Any-Winter-4079/Uno-and-ESP32-VLA-Robot/computer/LLM/exemplars/README.md

# Notes on `computer/LLM/exemplars/`:

## Use Case

The exemplars found on this folder are used by:

- `CoT_Dec_PAL_tester_v2.py`
- `CoT_Dec_PAL_tester_v3.py`

for early LLM experiments, which are not necessary to run the robot.

The results can be seen in more detail [here](https://github.com/Any-Winter-4079/Prompting-Experiments-2024).
