Any-Winter-4079/Uno-and-ESP32-VLA-Robot/M_Sc_Computer_Engineering_Defense.pdf

## Implementación de RAG en Robot Autónomo Controlado por LLM y Análisis de Desempeño y Aprendizaje en Entornos Reales

Eduardo Ariño Pelegrín

Universidad Politécnica de Madrid, España

Eduardo Ariño Pelegrín (Universidad Politécnica de Madrid, España) Implementación de RAG en Robot Autónomo Controlado por LLM y Análisis de Desempeño y Aprendizaje en Entornos Reales 1 / 10

## Motivación

Robótica
Necesita: Solución a
problema long tail.
Provee: Interfaces y
controladores para interactuar con el mundo físico.
Modelos de lenguaje
Proveen: Mayor capacidad de generalización.
Necesitan: En transición
hacia agentic AI,
retroalimentación del mundo físico.

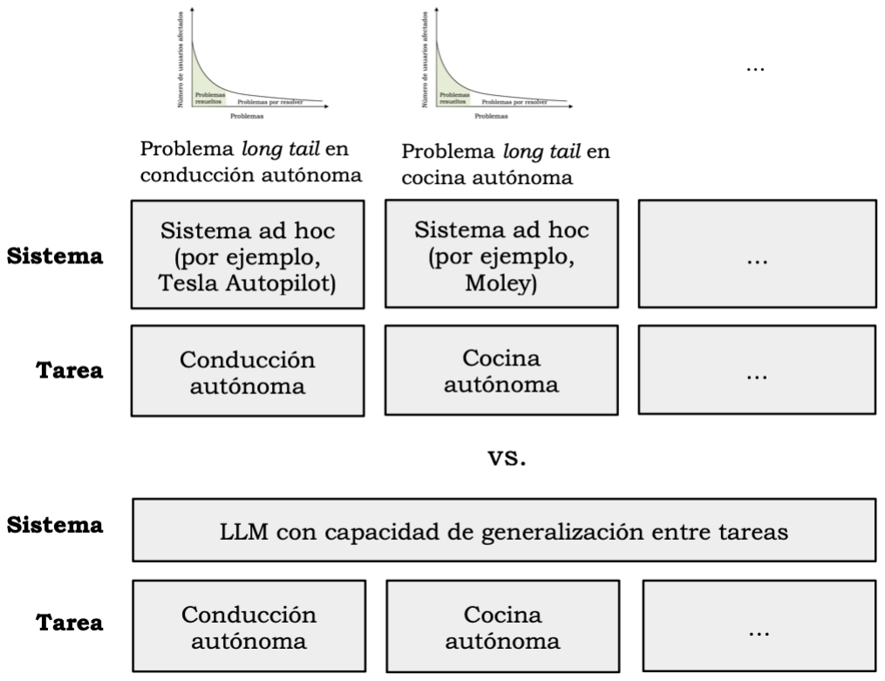
[picture p11: figure]

Eduardo Ariño Pelegrín (Universidad Politécnica de Madrid, España) Implementación de RAG en Robot Autónomo Controlado por LLM y Análisis de Desempeño y Aprendizaje en Entornos Reales 2 / 10

## Objetivos

Revisión de la literatura (SOTA).
Modelos de lenguaje, visión-lenguaje, visión-lenguaje-acción, etc. Diseño de robot.
ESP32-WROVER y Arduino (para enviar y recibir audio y comandos) Integración de modelo como controlador bajo framework propio. Entrada y salida de/hacia el mundo.
Módulos auxiliares: Rectificación, Reconocimiento de cara, etc.
Estudio de desempeño y aprendizaje en conducción y matemáticas (proxy de conocimiento general).
¿Puede un modelo controlar de forma autónoma interfaces físicas y virtuales (bajo este framework)? ¿Puntos de fallo?
¿Mejora con SFT? ¿Trade-offs?
¿Utilizan sus recuerdos? ¿Cómo?

Eduardo Ariño Pelegrín (Universidad Politécnica de Madrid, España) Implementación de RAG en Robot Autónomo Controlado por LLM y Análisis de Desempeño y Aprendizaje en Entornos Reales 3 / 10

## Estado del arte

(1) LM

Auto-supervisado
Auto-regresivo en
inferencia
(2) VLM

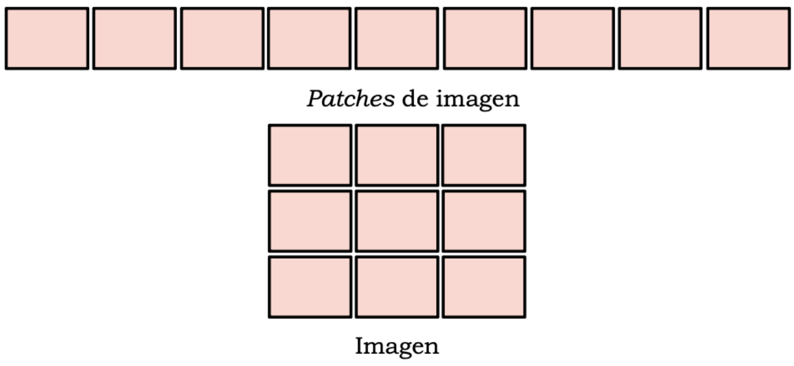
[picture p12: figure]

ViT
↓

CLIP-ViT SigLIP

Text
encoder

Image
encoder

MLP

Text decoder
(generativo)
(3) VLA

Visión-lenguaje (transición)

Planificadores de
tareas
Necesitan controlador
de bajo nivel
Ejemplo: PaLM-E

Visión-lenguaje-acción

action expert decoder
(flow-matching)
Generan action
chunks
Ejemplo: π0

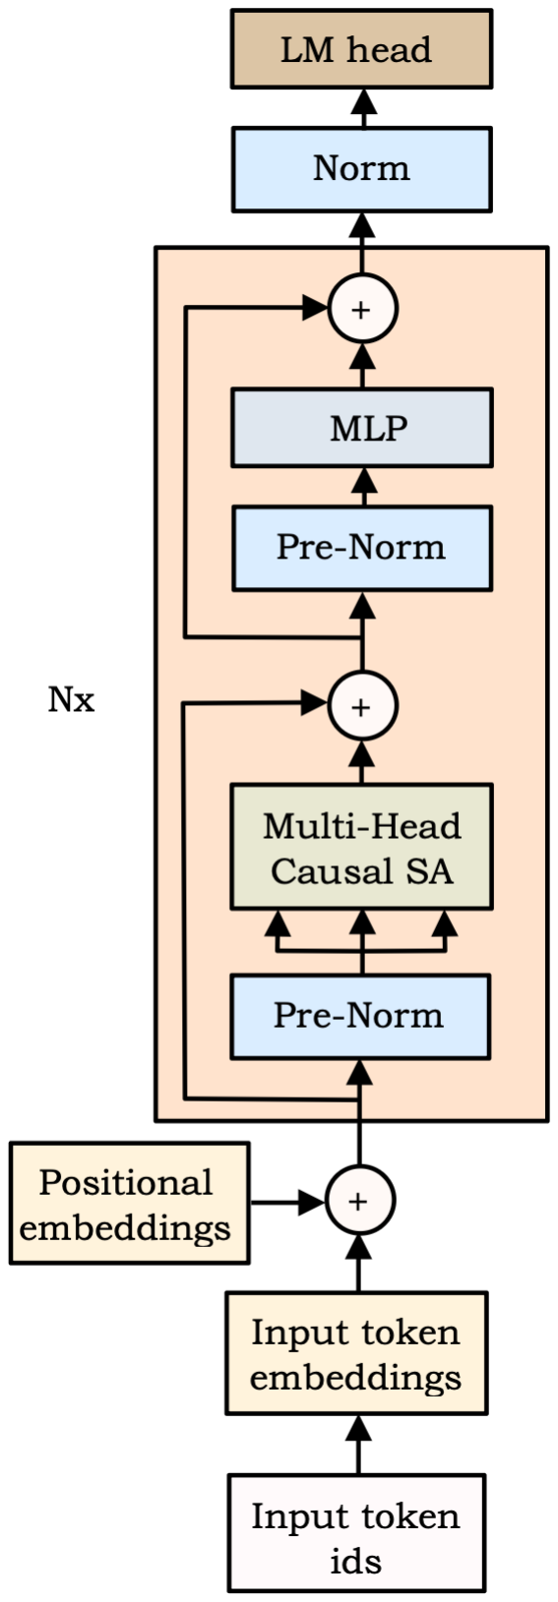
[picture p13: figure]

Eduardo Ariño Pelegrín (Universidad Politécnica de Madrid, España) Implementación de RAG en Robot Autónomo Controlado por LLM y Análisis de Desempeño y Aprendizaje en Entornos Reales 4 / 10

## Estado del arte

(4) Razonamiento

In-context learning
(modelos mejoran con
ejemplos/few-shot)
↓
Prompting
(CoT) | (PAL) ↙ | ↘
Thinking tokens | | Tool use
(5) RAG

Sparse

basados en
frecuencia

Ejemplos:
TF-IDF,
BM25

Dense

basados en
encoders

Ejemplos:
ColBERT,
SBERT

Hybrid

mix

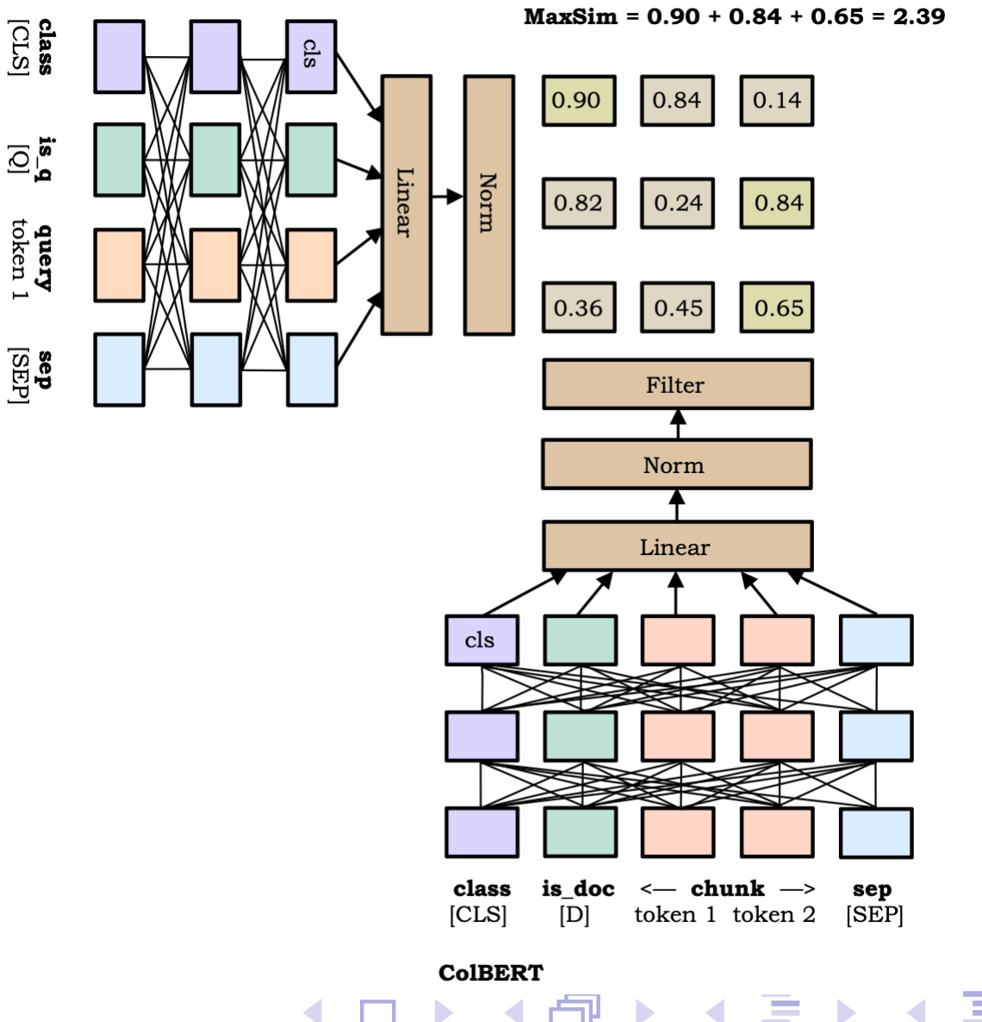
[picture p14: figure]

Eduardo Ariño Pelegrín (Universidad Politécnica de Madrid, España) Implementación de RAG en Robot Autónomo Controlado por LLM y Análisis de Desempeño y Aprendizaje en Entornos Reales 5 / 10

## Metodología: Decisiones de diseño bajo un caso de uso

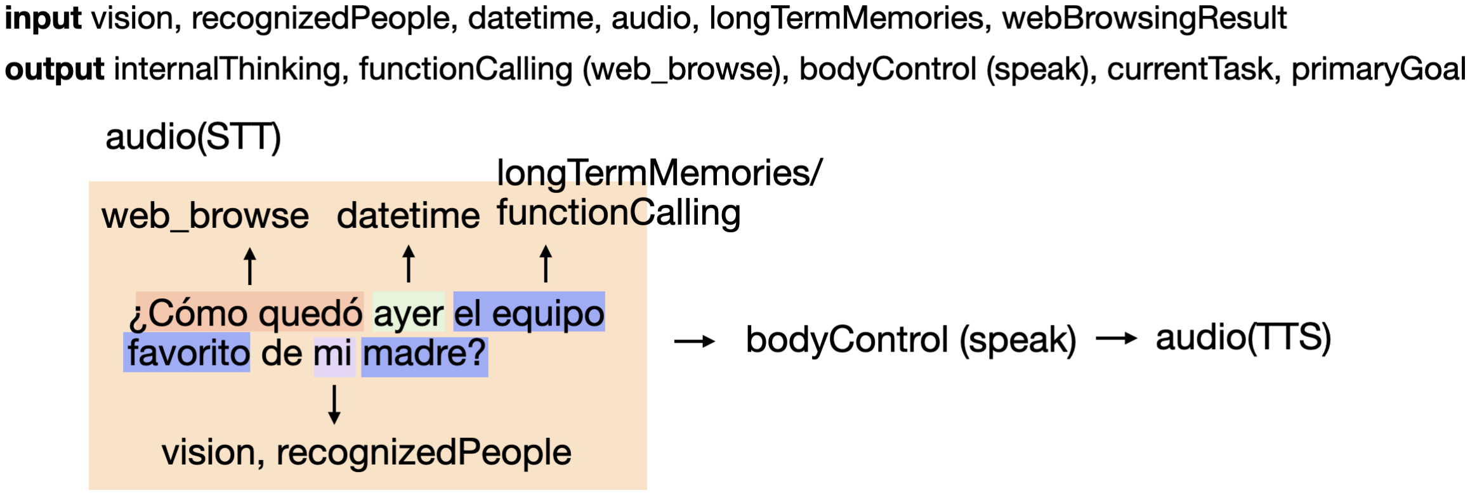
[picture p15: figure]

## Desarrollo: Cuerpo de robot

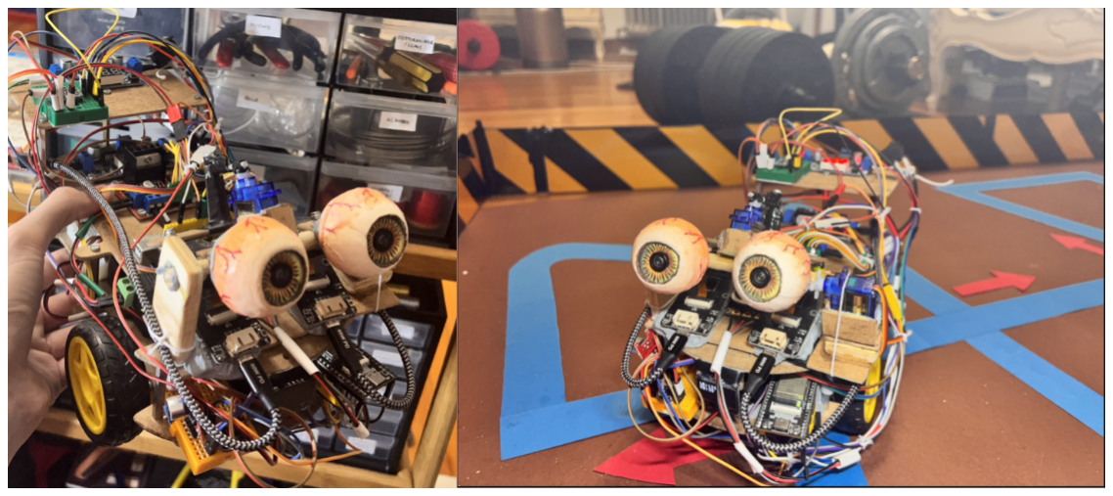
[picture p16: figure]

## Desarrollo: Resumen de funcionamiento

Audio de KY-037, INMP441,
ESP32-WROVER →
Ordenador

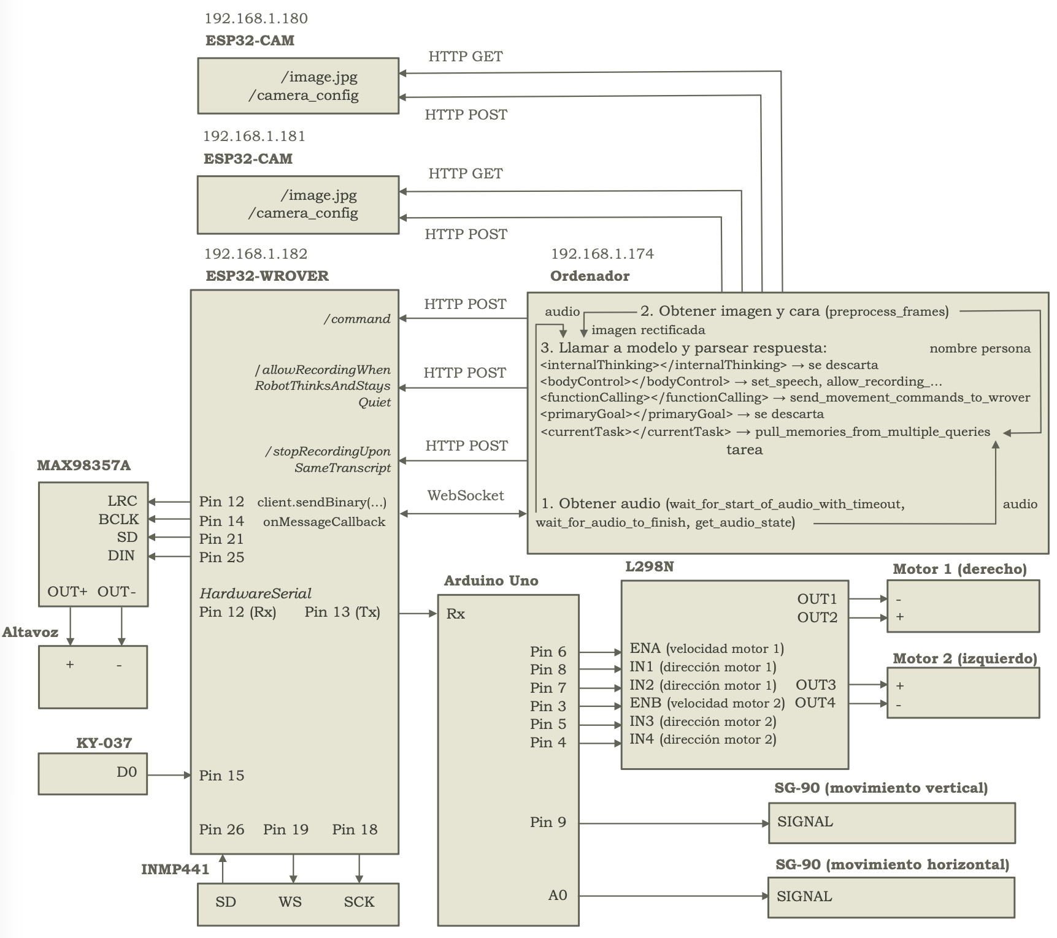
[picture p17: figure]

Imágenes de ESP32-CAM →
Ordenador
Obtención de recuerdos
(sobre cara, audio, tarea, o bajo demanda)

Qwen3-VL (remote/Modal)

Parseo de comandos
(ordenador) →
ESP32-WROVER →
MAX98357A / Arduino →
L298N → motores

Parseo de funciones
(ordenador) → ejecución
(bloqueante)

## Resultados y conclusiones

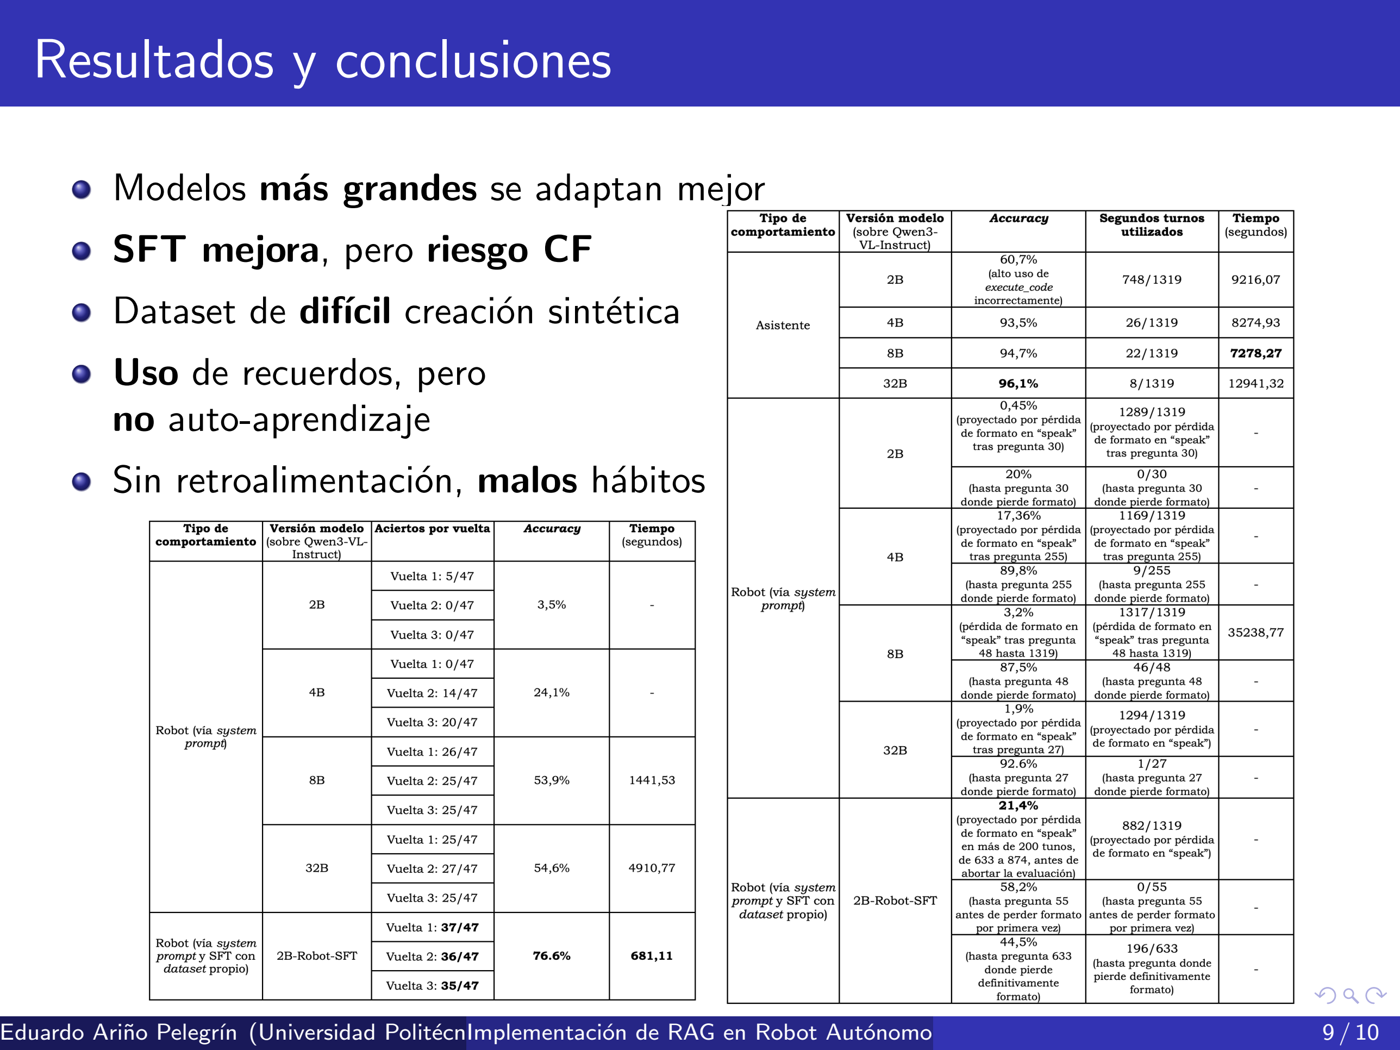
[picture p18: page 9]

Modelos más grandes se adaptan mejor SFT mejora, pero riesgo CF

Dataset de difícil creación sintética

Uso de recuerdos, pero
no auto-aprendizaje
Sin retroalimentación, malos hábitos

Eduardo Ariño Pelegrín (Universidad Politécnica de Madrid, España) Implementación de RAG en Robot Autónomo Controlado por LLM y Análisis de Desempeño y Aprendizaje en Entornos Reales 9 / 10

## Líneas futuras

Software
SFT: (1) Token weighing, (2) 2 fases (vision+MLP+lenguaje, lenguaje), (3) portar datasets a framework
Entrada sensorial: audio e imágenes secuenciales → captura continua Arquitectura: Cross-attention, action expert, omni, paralelización salida (pensamiento interno, movimiento cuerpo, habla, etc.)
Hardware
Visión: 2 cámaras incrustadas → 1 cámara de mayor calidad
Movimiento: 2 ruedas (2 motores) + rueda loca → 4 ruedas (4 motores) Audio: Mejor micrófono para evitar necesidad de enunciación/alto volumen

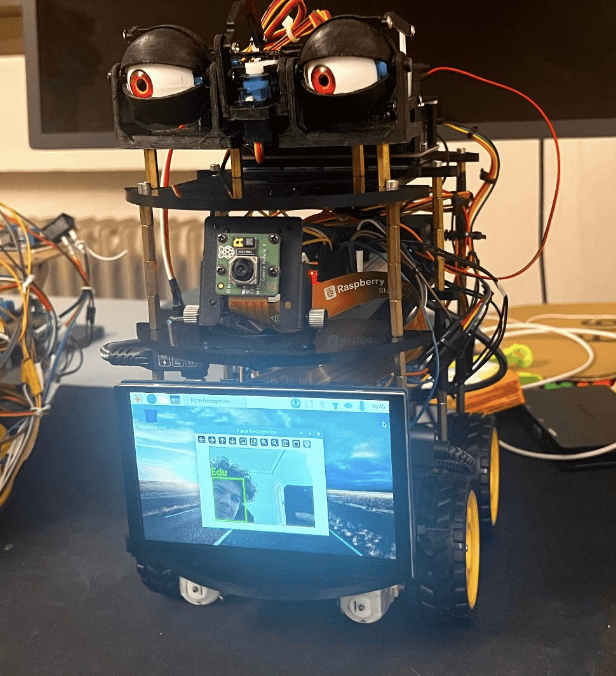
[picture p19: figure]

Eduardo Ariño Pelegrín (Universidad Politécnica de Madrid, España) Implementación de RAG en Robot Autónomo Controlado por LLM y Análisis de Desempeño y Aprendizaje en Entornos Reales 10 / 10
