Any-Winter-4079/Uno-and-ESP32-VLA-Robot/computer/LLM/datasets/vla_sft_dataset/images/scene_0001_hello_world_dialogue/image_0003.jpg

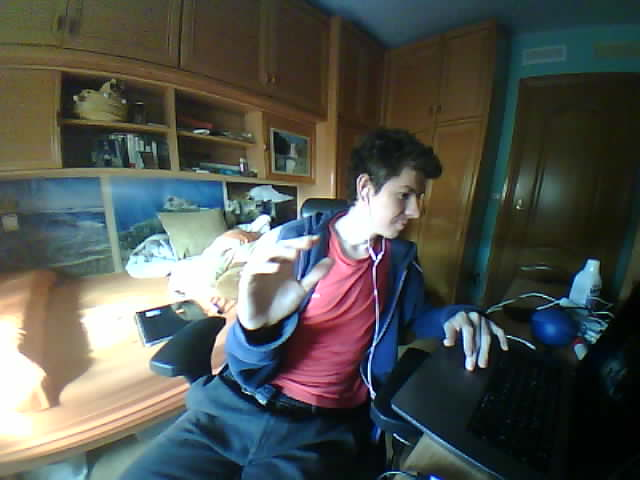
computer/LLM/datasets/vla_sft_dataset/images/scene_0001_hello_world_dialogue/image_0003.jpg
