Any-Winter-4079/Uno-and-ESP32-VLA-Robot/computer/LLM/datasets/vla_sft_dataset/images/scene_0002_code_execution_dialogue/image_0004.jpg

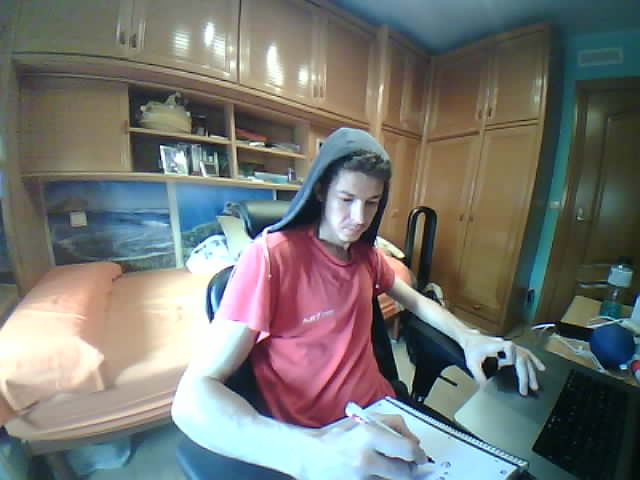
computer/LLM/datasets/vla_sft_dataset/images/scene_0002_code_execution_dialogue/image_0004.jpg
