Any-Winter-4079/Uno-and-ESP32-VLA-Robot/computer/LLM/datasets/vla_sft_dataset/images/scene_0003_driving/image_0017.jpg

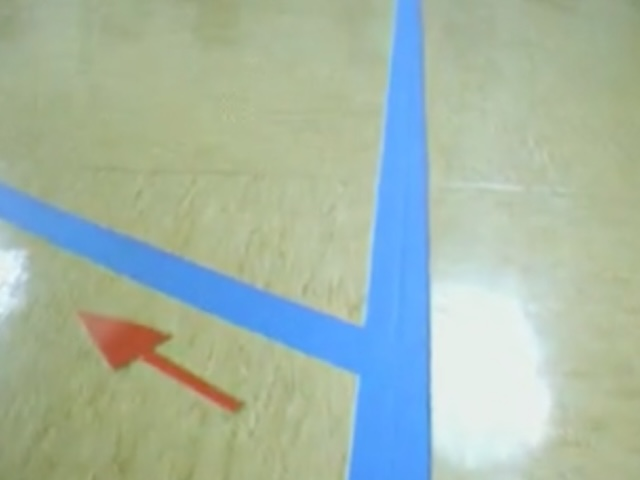
computer/LLM/datasets/vla_sft_dataset/images/scene_0003_driving/image_0017.jpg
