Any-Winter-4079/Uno-and-ESP32-VLA-Robot/guides/00_connections.md

The connection's diagram (showing both power and communication), is the following, with the only difference being a 7.4V battery is used in place of the diagram's two 3.7V batteries in series.

<div align="center">
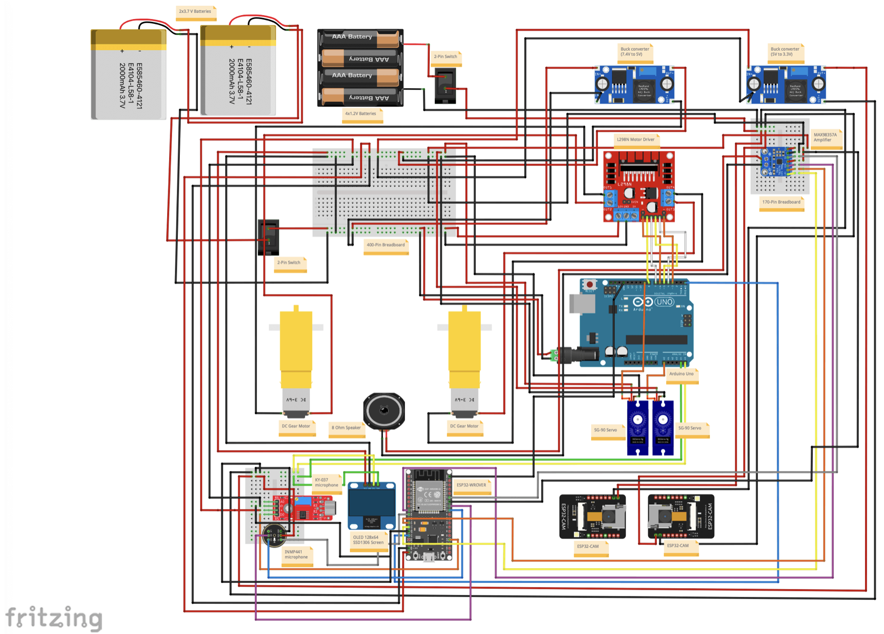
[picture p62: images/original/connections.png]
Connections
    
    <p>Connection diagram (Fritzing)</p>
</div>
