Any-Winter-4079/Uno-and-ESP32-VLA-Robot/computer/calibration/images/corners_side_by_side/20240220_215308_side_by_side.jpg

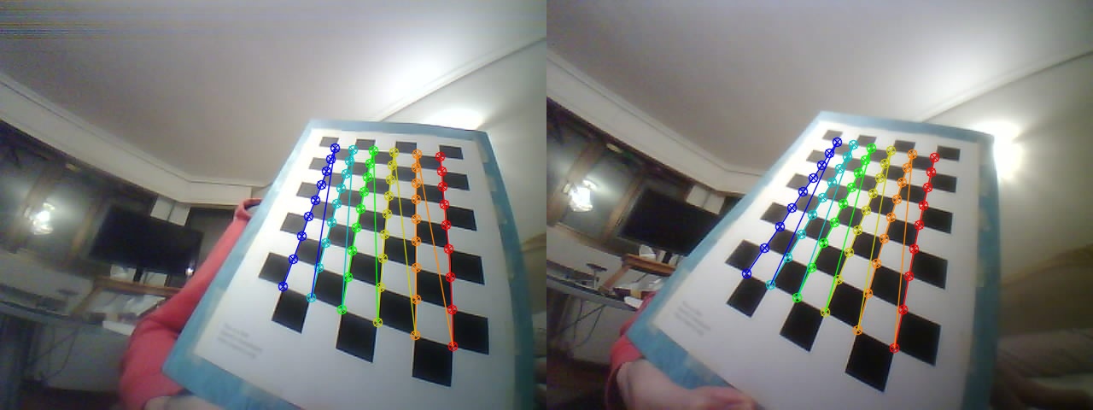
computer/calibration/images/corners_side_by_side/20240220_215308_side_by_side.jpg
