Any-Winter-4079/Uno-and-ESP32-VLA-Robot/computer/LLM/datasets/vla_eval_on_benchmark_dataset/images/correct_and_new_question/image_0002.jpg

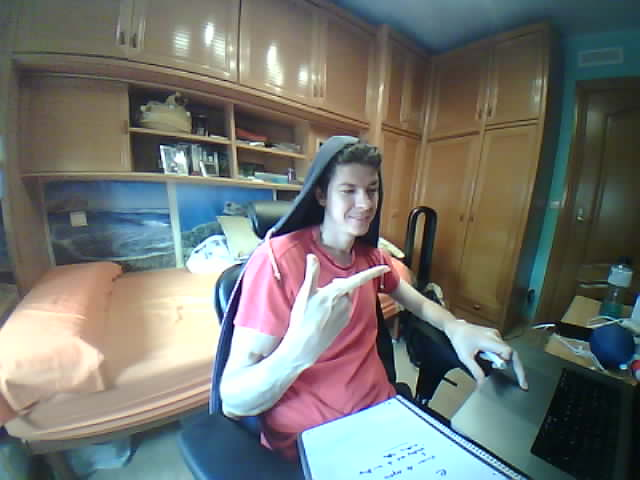
computer/LLM/datasets/vla_eval_on_benchmark_dataset/images/correct_and_new_question/image_0002.jpg
