Any-Winter-4079/Uno-and-ESP32-VLA-Robot/computer/LLM/datasets/vla_eval_on_benchmark_dataset/images/incorrect_and_new_question/image_0001.jpg

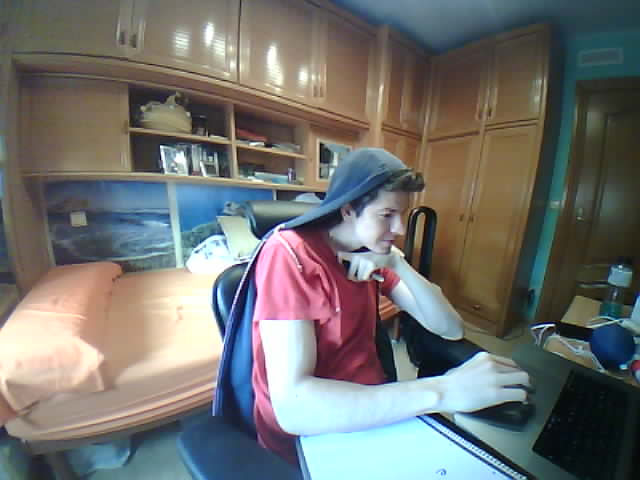
computer/LLM/datasets/vla_eval_on_benchmark_dataset/images/incorrect_and_new_question/image_0001.jpg
