Any-Winter-4079/Uno-and-ESP32-VLA-Robot/computer/undistortion_and_rectification/images/undistorted_and_rectified_calibration_images/image_20240220_214038.jpg

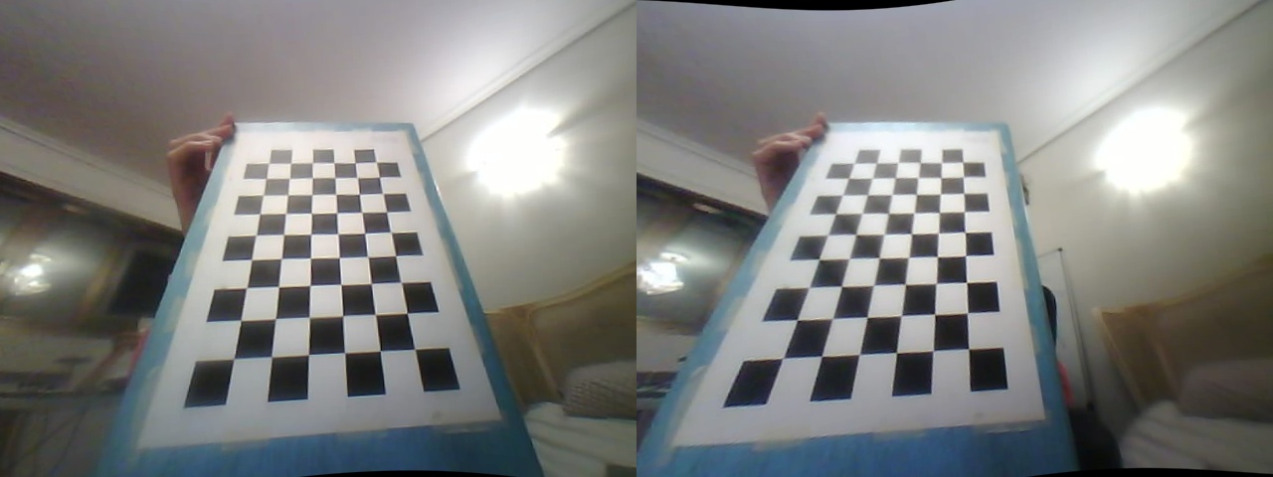
computer/undistortion_and_rectification/images/undistorted_and_rectified_calibration_images/image_20240220_214038.jpg
