Any-Winter-4079/Uno-and-ESP32-VLA-Robot/(commit log)

2025-11-09 add arduino uno sketches
2025-11-09 add esp32 (wrover, cam) sketches
2025-11-09 add several ESP32 pinouts
2025-11-09 add chassis and motors guide with images
2025-11-09 add vision and eye movement guide wih images and update chassis and motors guide
2025-11-10 add frame rate study, calibration, distortion correction and rectification guides, with images
2025-11-10 add calibration images
2025-11-10 add calibration parameters
2025-11-10 add calibration scripts to (1) store images and (2) to calibrate, plus README
2025-11-21 update print style
2025-12-06 add dataset text fix
    [create_dataset_with_image_per_turn.py]
2025-12-07 add minor create dataset comment fixes
    [create_dataset_with_image_per_turn.py]
2025-12-07 update audio to expose ESP32_REQUEST_TIMEOUT and add timeout comments
2025-12-07 fix dataset model comments
    [create_dataset_with_image_per_turn.py]
2025-12-09 remove debug print from unknown faces recognition benchmark
2025-12-10 add servos and motors test scripts
